cjf646/ESEProj/README.md

# ESEProj
Final Capstone project for Electronic Systems Engineering at the University of Regina.
