cjf646/ESEProj/Box Stuff/Box Stuff/Pics/Back wall.jpg

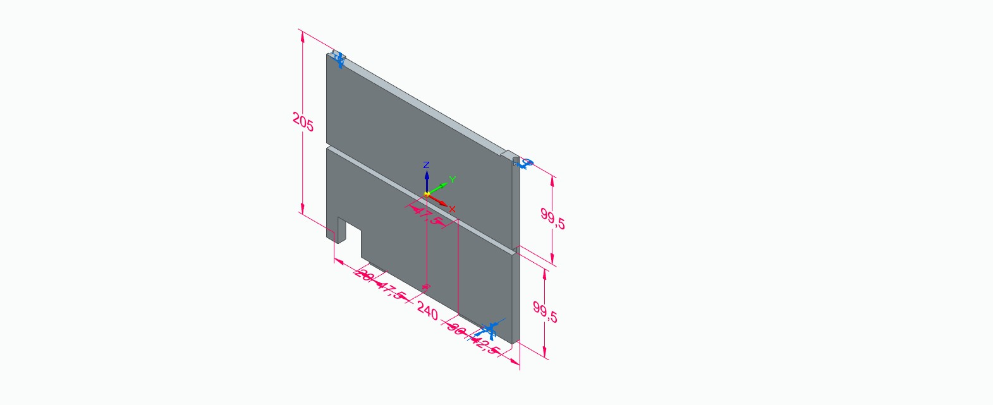
Box Stuff/Box Stuff/Pics/Back wall.jpg
