cjf646/ESEProj/Box Stuff/Box Stuff/Pics/Box (FrontxTopxRight).jpg

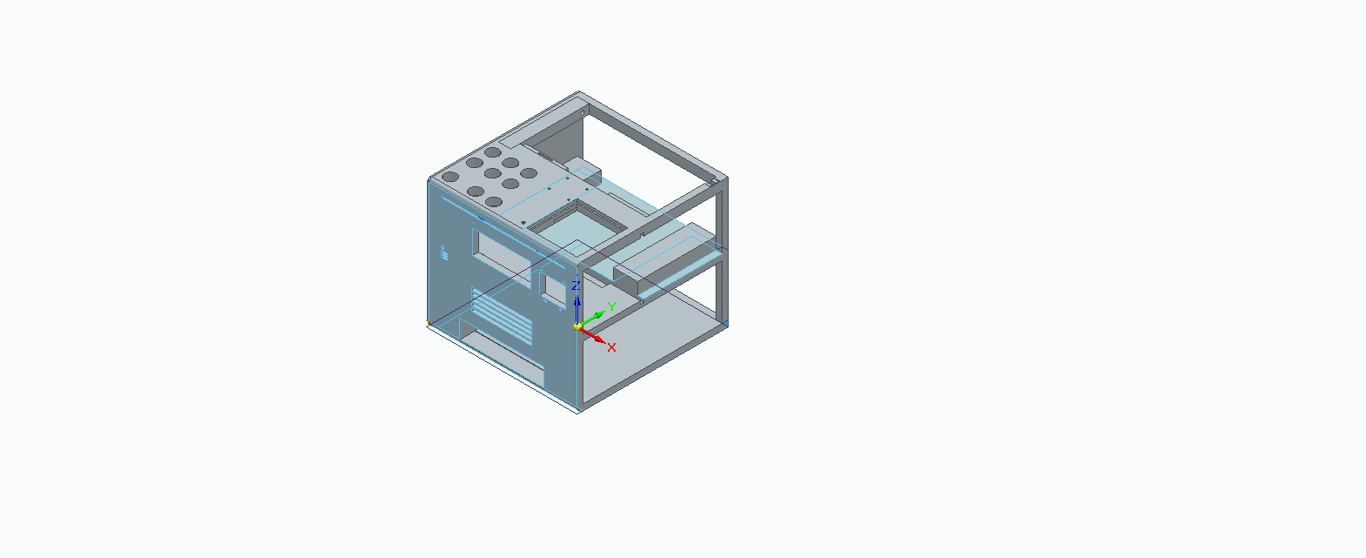
Box Stuff/Box Stuff/Pics/Box (FrontxTopxRight).jpg
