cjf646/ESEProj/Box Stuff/Box Stuff/Pics/Box (RightxTopxBack).jpg

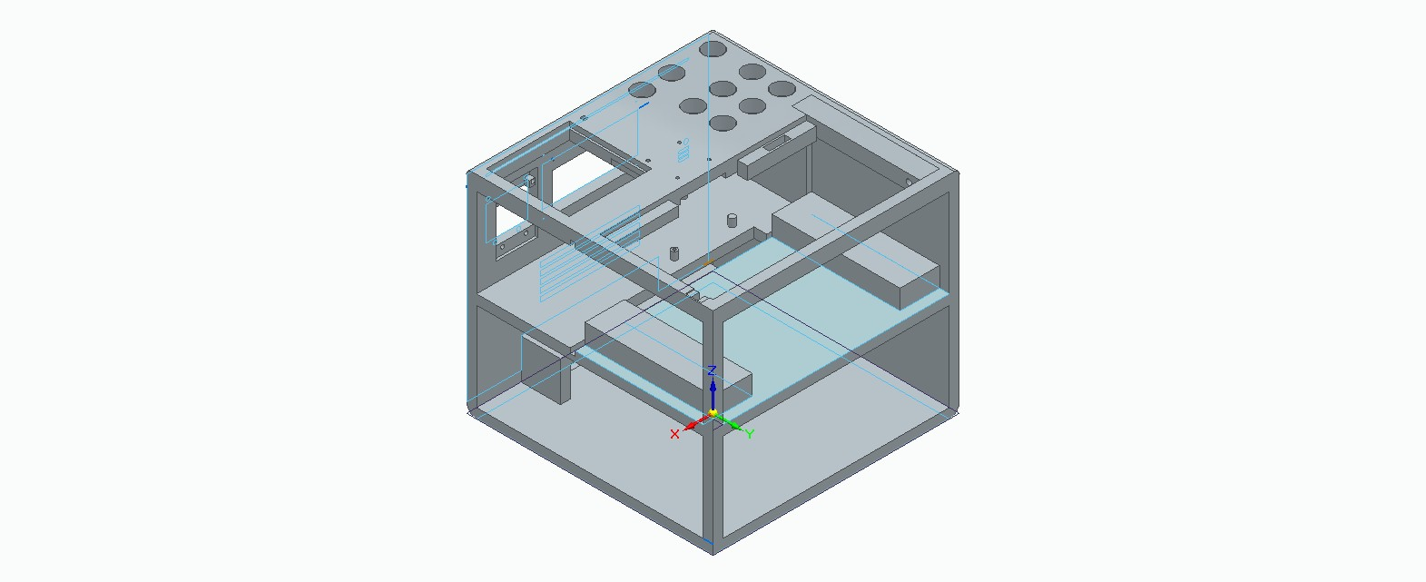
Box Stuff/Box Stuff/Pics/Box (RightxTopxBack).jpg
