cjf646/ESEProj/Box Stuff/Box Stuff/Pics/floor wall.jpg

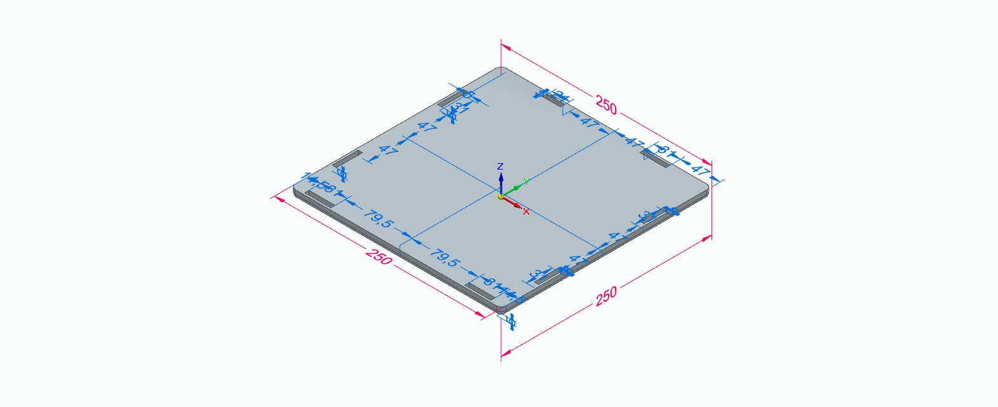
Box Stuff/Box Stuff/Pics/floor wall.jpg
