cjf646/ESEProj/Box Stuff/Box Stuff/Pics/front wall.jpg

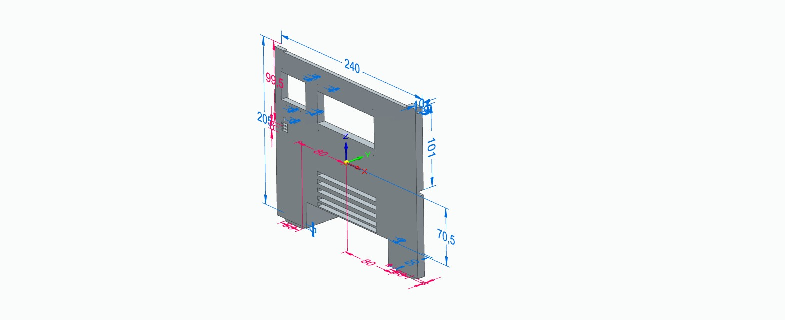
Box Stuff/Box Stuff/Pics/front wall.jpg
