cjf646/ESEProj/Box Stuff/Box Stuff/Pics/left wall.jpg

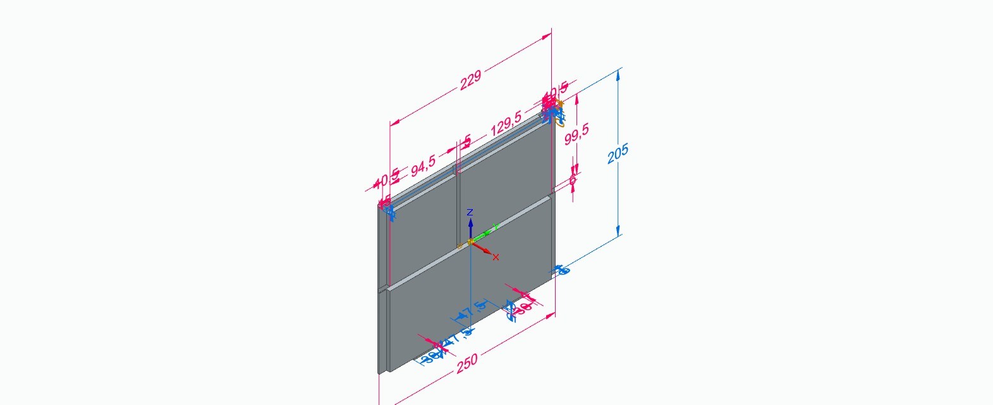
Box Stuff/Box Stuff/Pics/left wall.jpg
