cjf646/ESEProj/Box Stuff/Box Stuff/Pics/Lid.jpg

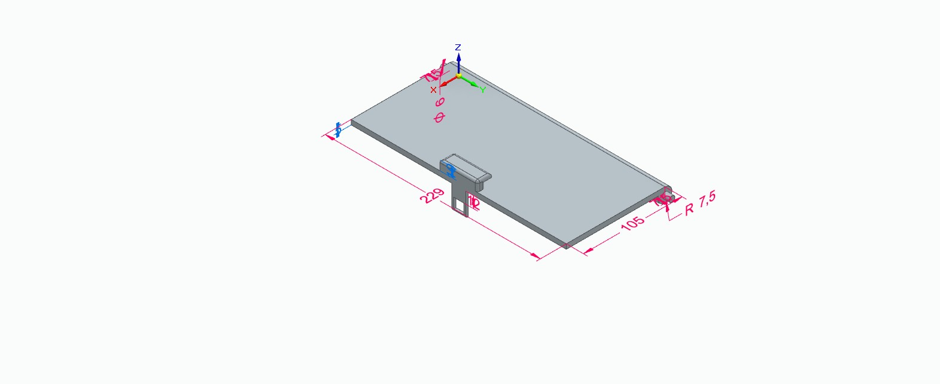
Box Stuff/Box Stuff/Pics/Lid.jpg
