cjf646/ESEProj/Box Stuff/Box Stuff/Pics/middle wall.jpg

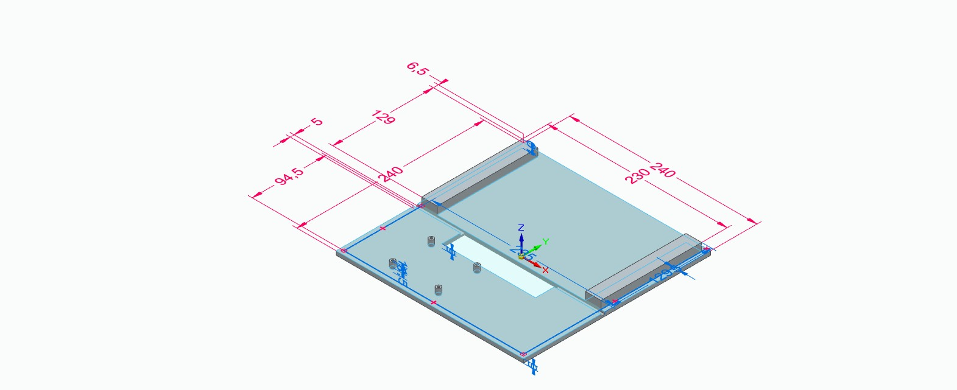
Box Stuff/Box Stuff/Pics/middle wall.jpg
