cjf646/ESEProj/Box Stuff/Box Stuff/Pics/right wall.jpg

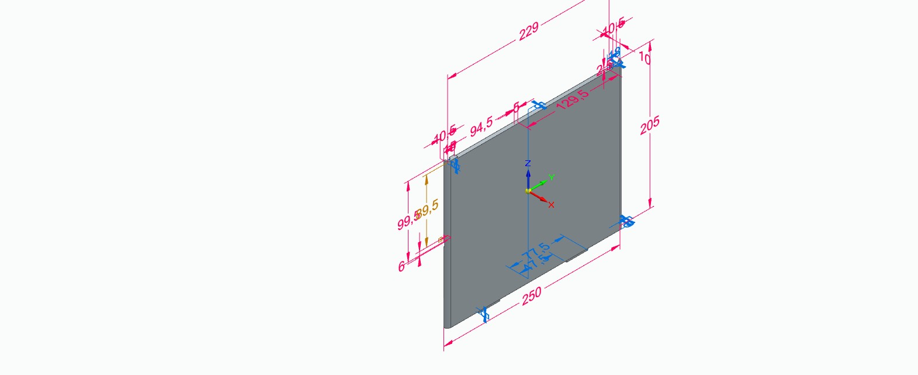
Box Stuff/Box Stuff/Pics/right wall.jpg
