cjf646/ESEProj/Box Stuff/Box Stuff/Pics/Sliding wall.jpg

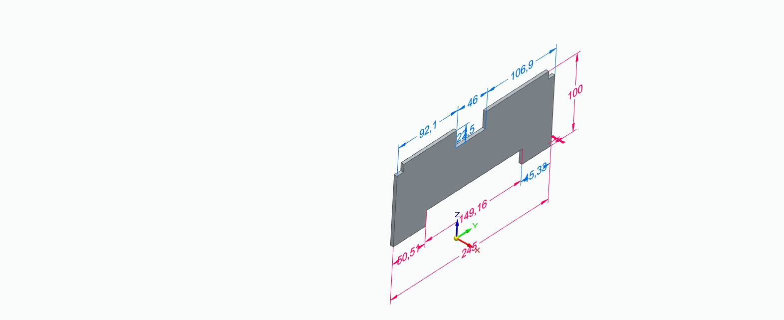
Box Stuff/Box Stuff/Pics/Sliding wall.jpg
