cjf646/ESEProj/Box Stuff/Box Stuff/Pics/top wall.jpg

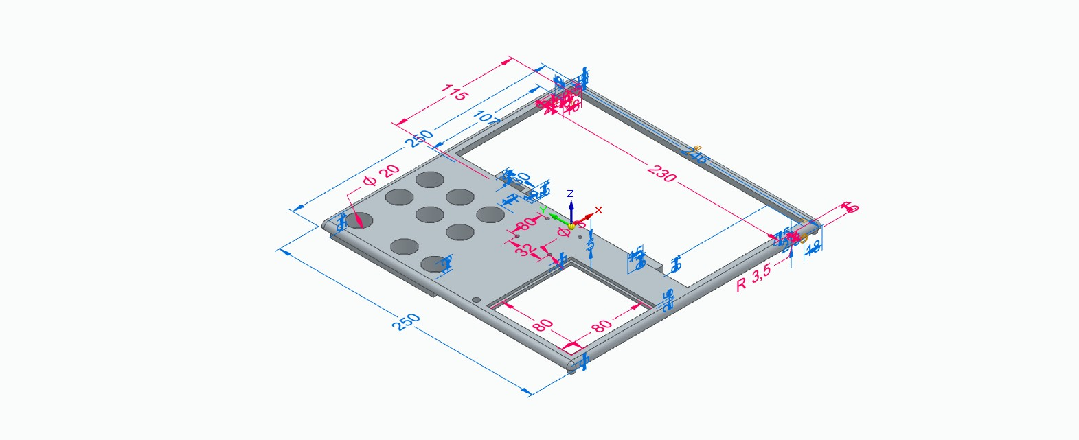
Box Stuff/Box Stuff/Pics/top wall.jpg
