cjf646/ESEProj/Box Stuff/Box Stuff/stl/Lid.stl

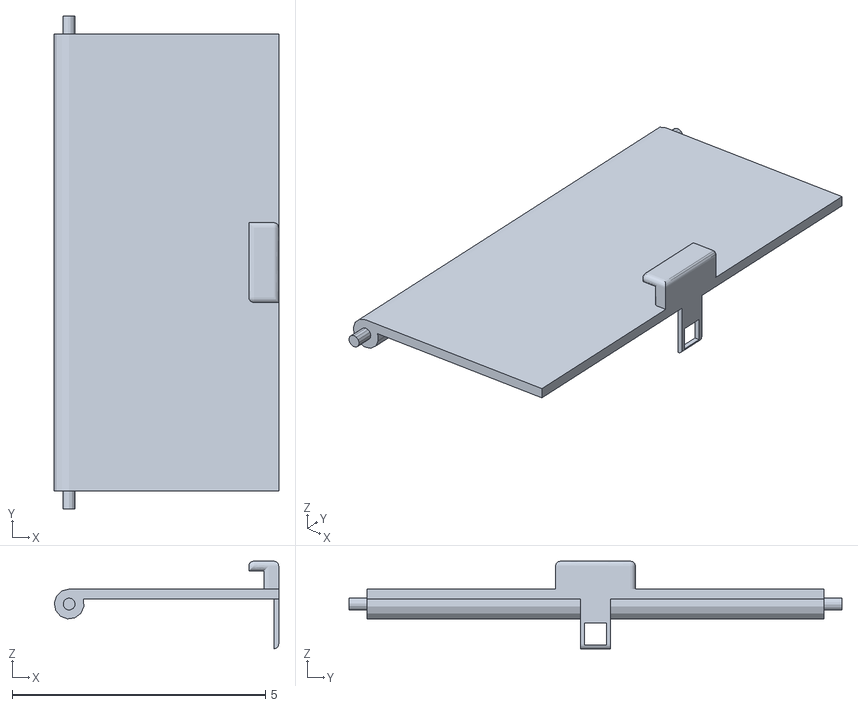
[picture p18: CAD file, 2023-02-28]
Box Stuff/Box Stuff/stl/Lid.stl
4.43 x 9.72 x 1.73
