cjf646/ESEProj/Box Stuff/Box Stuff/numb.stl

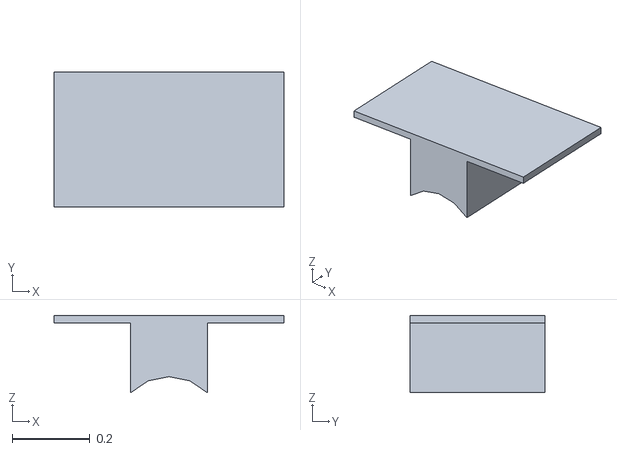
[picture p19: CAD file, 2023-01-17]
Box Stuff/Box Stuff/numb.stl
0.591 x 0.346 x 0.199
