cjf646/ESEProj/Box Stuff/Box Stuff/stl/front wall.stl

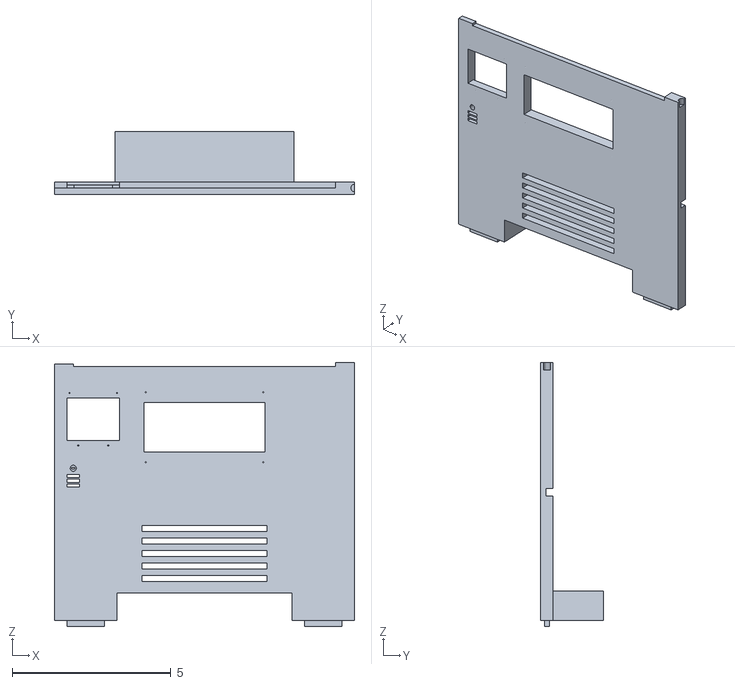
[picture p20: CAD file, 2023-01-30]
Box Stuff/Box Stuff/stl/front wall.stl
9.45 x 1.97 x 8.33
