cjf646/ESEProj/Box Stuff/Box Stuff/Sliding wall.stl

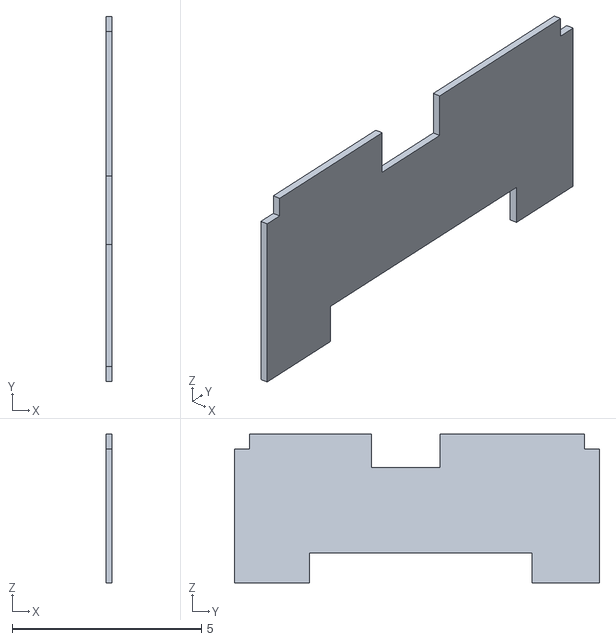
[picture p21: CAD file, 2023-01-17]
Box Stuff/Box Stuff/Sliding wall.stl
0.157 x 9.65 x 3.94
