cjf646/ESEProj/Box Stuff/Box Stuff/stl/floor wall.stl

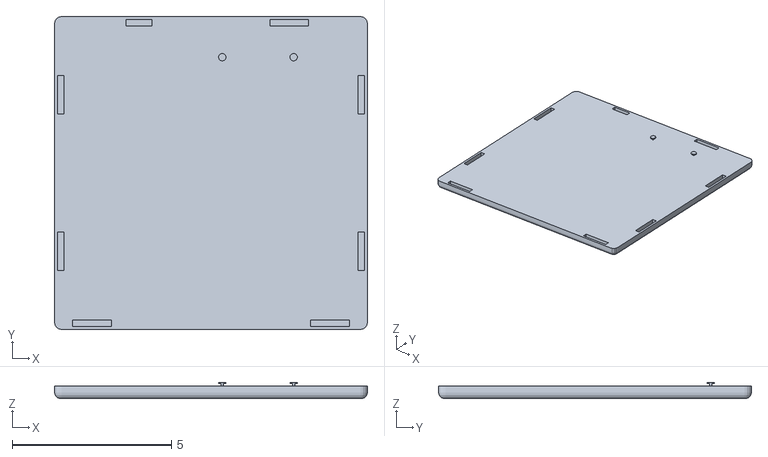
[picture p22: CAD file, 2023-01-30]
Box Stuff/Box Stuff/stl/floor wall.stl
9.84 x 9.84 x 0.512
