cjf646/ESEProj/Box Stuff/Box Stuff/Box.stl

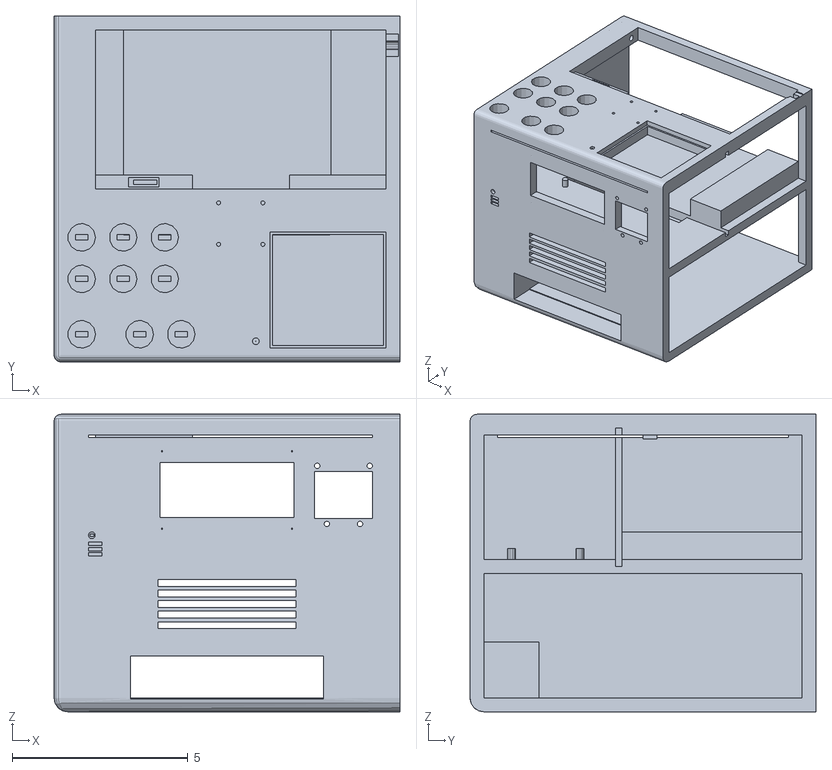
[picture p23: CAD file, 2023-01-17]
Box Stuff/Box Stuff/Box.stl
9.84 x 9.84 x 8.46
