cjf646/ESEProj/Box Stuff/Box Stuff/stl/Back wall.stl

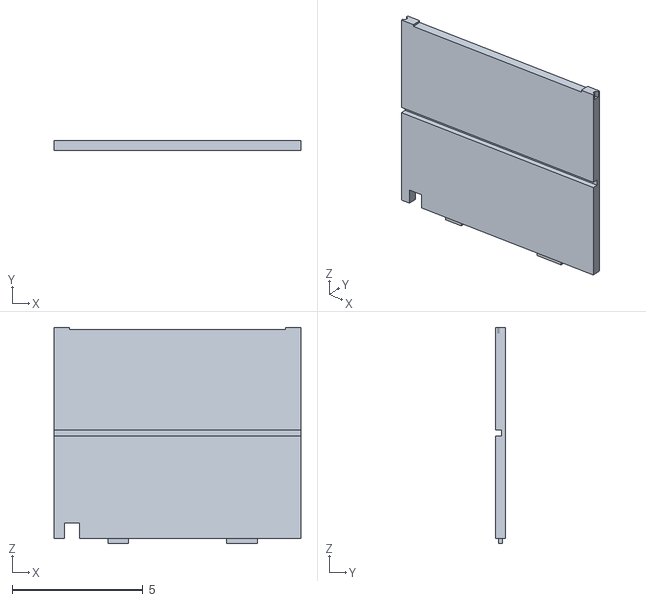
[picture p24: CAD file, 2023-01-30]
Box Stuff/Box Stuff/stl/Back wall.stl
9.45 x 0.394 x 8.27
