cjf646/ESEProj/Box Stuff/Box Stuff/stl/top wall.stl

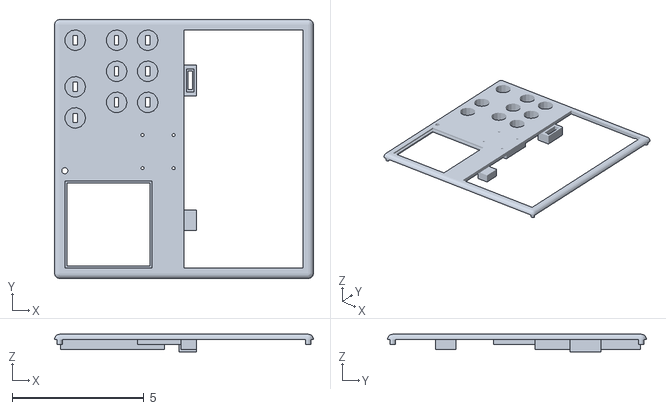
[picture p25: CAD file, 2023-01-28]
Box Stuff/Box Stuff/stl/top wall.stl
9.84 x 9.84 x 0.669
