cjf646/ESEProj/Box Stuff/Box Stuff/stl/left wall.stl

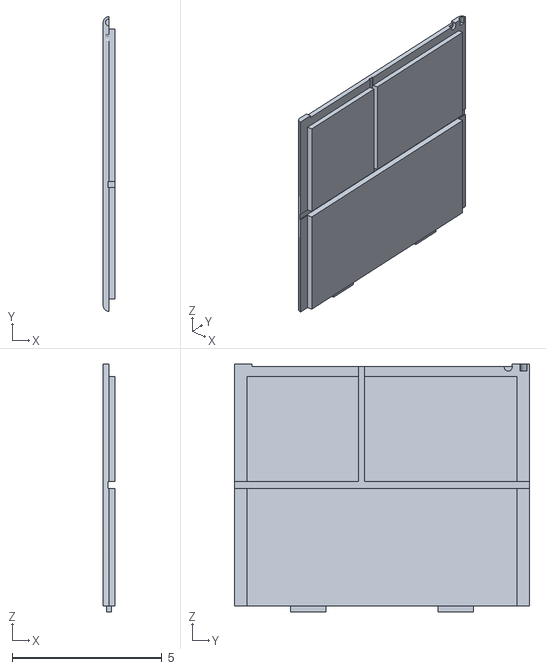
[picture p26: CAD file, 2023-01-28]
Box Stuff/Box Stuff/stl/left wall.stl
0.394 x 9.84 x 8.27
