cjf646/ESEProj/Box Stuff/Box Stuff/stl/middle wall.stl

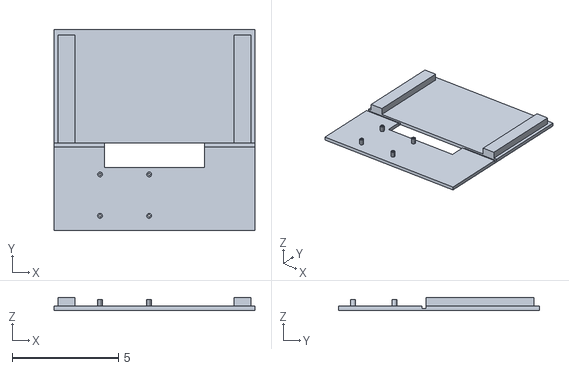
[picture p27: CAD file, 2023-01-27]
Box Stuff/Box Stuff/stl/middle wall.stl
9.45 x 9.45 x 0.591
