cjf646/ESEProj/(list of files, cad)

Other CAD files:
Box Stuff/Box Stuff/box_updated_jan11.dwg
Schematics/rasbpi.dwg
Schematics/power.dwg
Box Stuff/Box Stuff/stl/right wall.stl
Box Stuff/Box Stuff/Lid.stl
Box Stuff/Box Stuff/top wall.stl
