cjf646/ESEProj/Schematics/rasbpi8_5x11.pdf

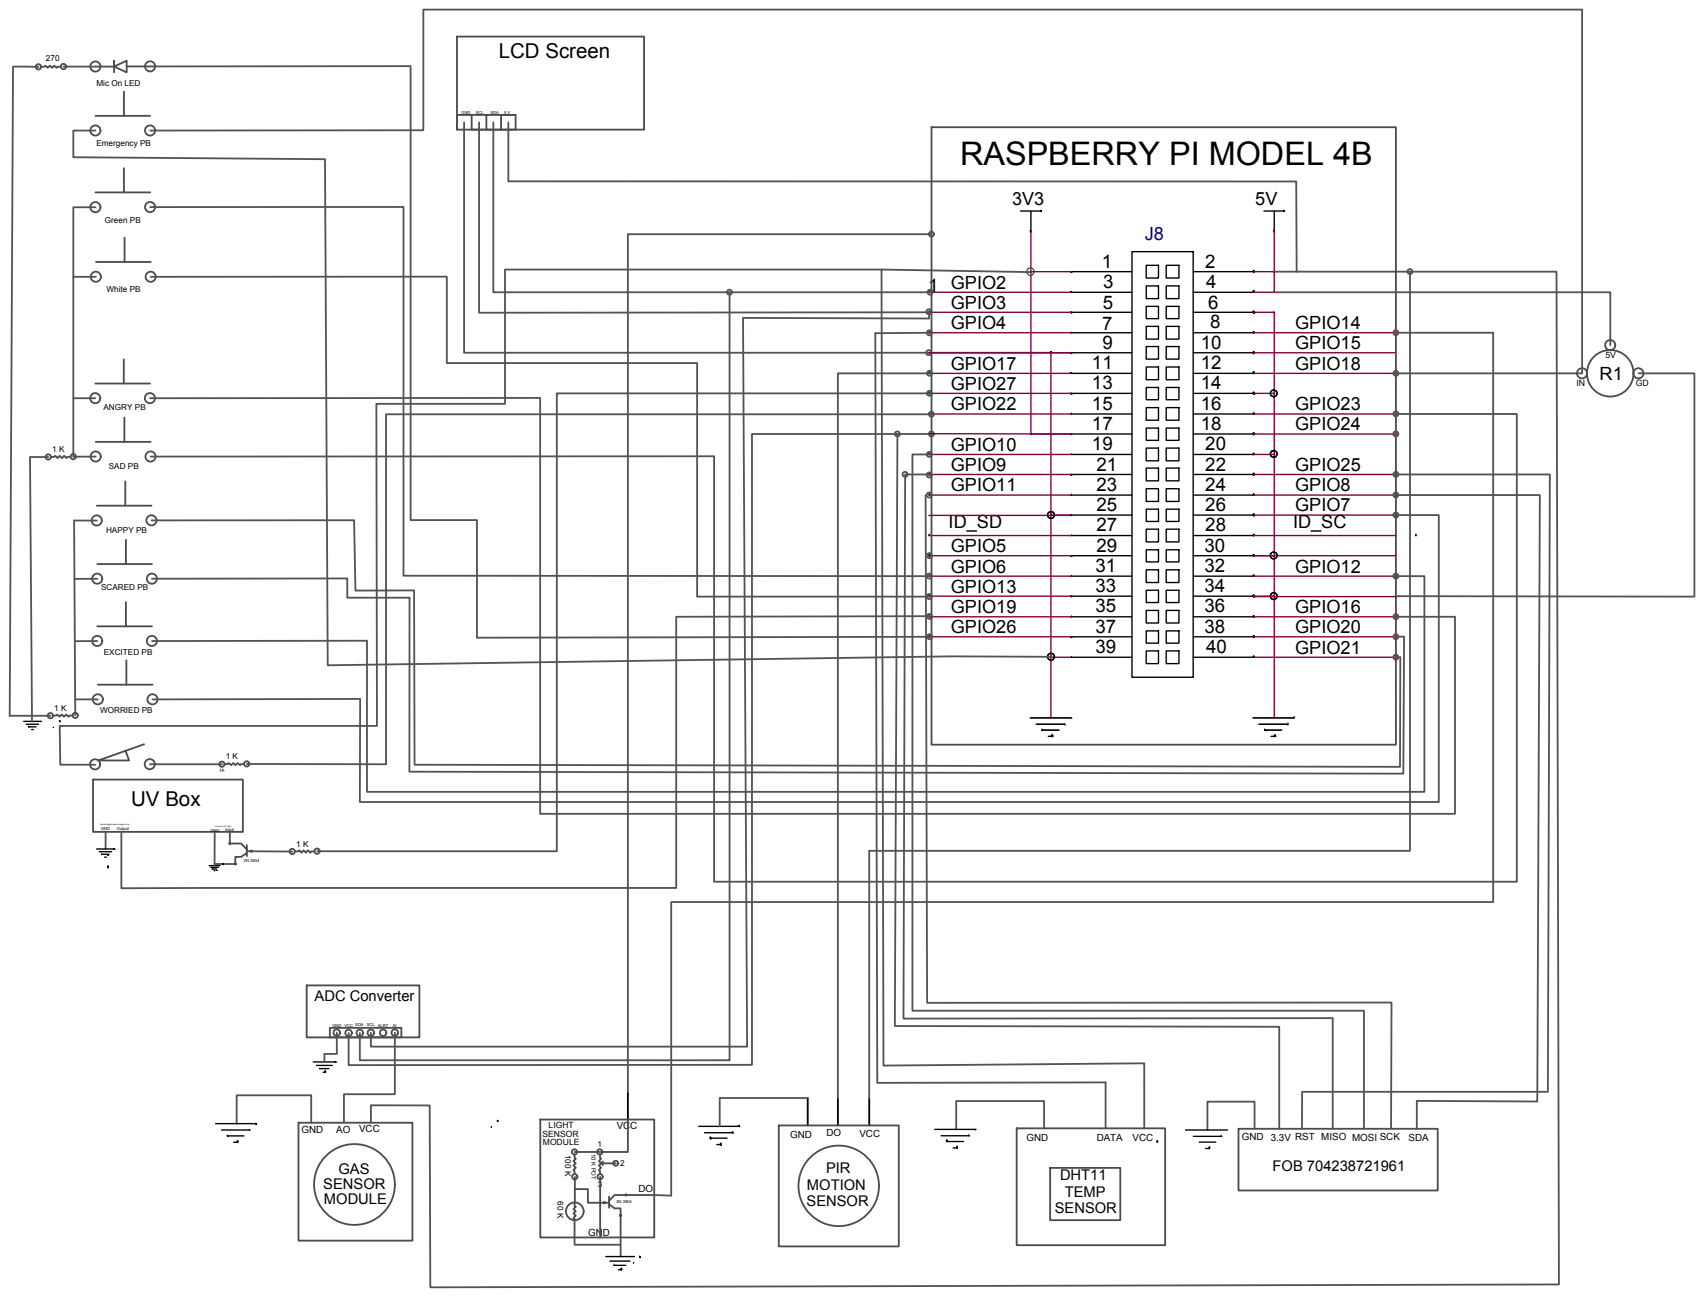
[picture p28: page 1]
5V J8 GPIO2 GPIO3 GPIO4 GPIO17 GPIO27 GPIO22 GPIO10 GPIO9 GPIO11 ID_SD GPIO5 GPIO6 GPIO13 GPIO19 GPIO26; GPIO14 GPIO15 GPIO18 GPIO23 GPIO24 GPIO25 GPIO8 GPIO7 ID_SC GPIO12 GPIO16 GPIO20 GPIO21 RASPBERRY PI MODEL 4B GNDMOTION SENSOR; GND; DATA DHT11 SENSOR PIR; VCC TEMP GND MODULE SENSOR LIGHT LCD Screen; 68 1 Green PB White PBUV Box GND; Output; Input; FOB 704238721961 GND 3.3V RST MISO MOSI SCK SDA GNDMODULE SENSOR GAS; DO AO VCC; VCC GND VCC SDA SCL ALRT AI; VCC GND; SCL; SDA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

10 K POT 60 K 5V IN GD 1A 1 K
