cjf646/ESEProj/Schematics/TEMPLATE PI.pdf

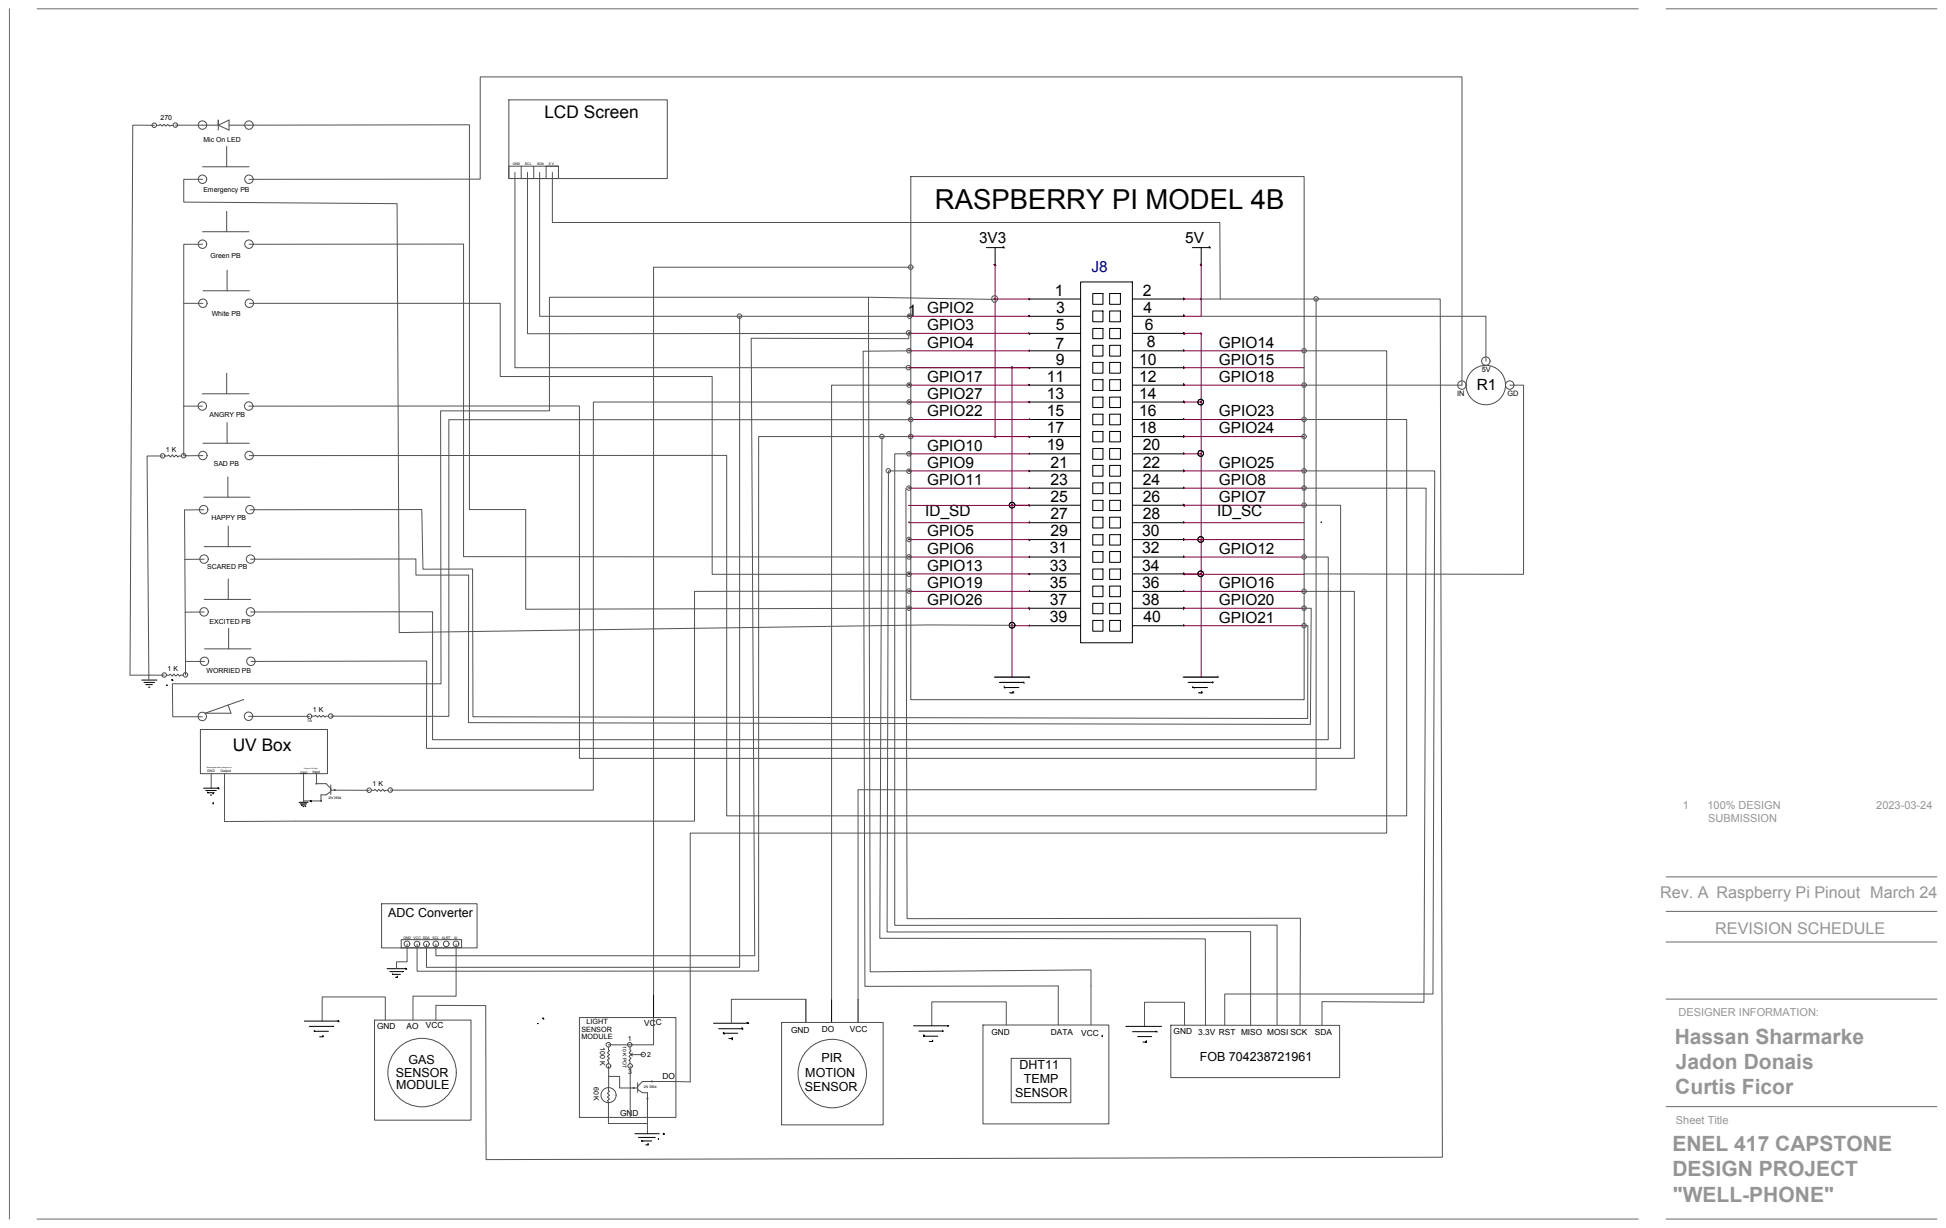
[picture p29: page 1]
Sheet Title DESIGNER INFORMATION: Hassan Sharmarke Jadon Donais Curtis Ficor REVISION SCHEDULE Rev. A Raspberry Pi Pinout March 24 ENEL 417 CAPSTONE DESIGN PROJECT "WELL-PHONE" 1; 100% DESIGN SUBMISSION; 5V J8 GPIO2 GPIO3 GPIO4 GPIO17 GPIO27 GPIO22 GPIO10 GPIO9 GPIO11 ID_SD GPIO5 GPIO6 GPIO13 GPIO19 GPIO26; GPIO14 GPIO15 GPIO18 GPIO23 GPIO24 GPIO25 GPIO8 GPIO7 ID_SC GPIO12 GPIO16 GPIO20 GPIO21 RASPBERRY PI MODEL 4B GNDMOTION SENSOR; GND; DATA DHT11 SENSOR PIR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
