cjf646/ESEProj/Schematics/power8_5x11.pdf

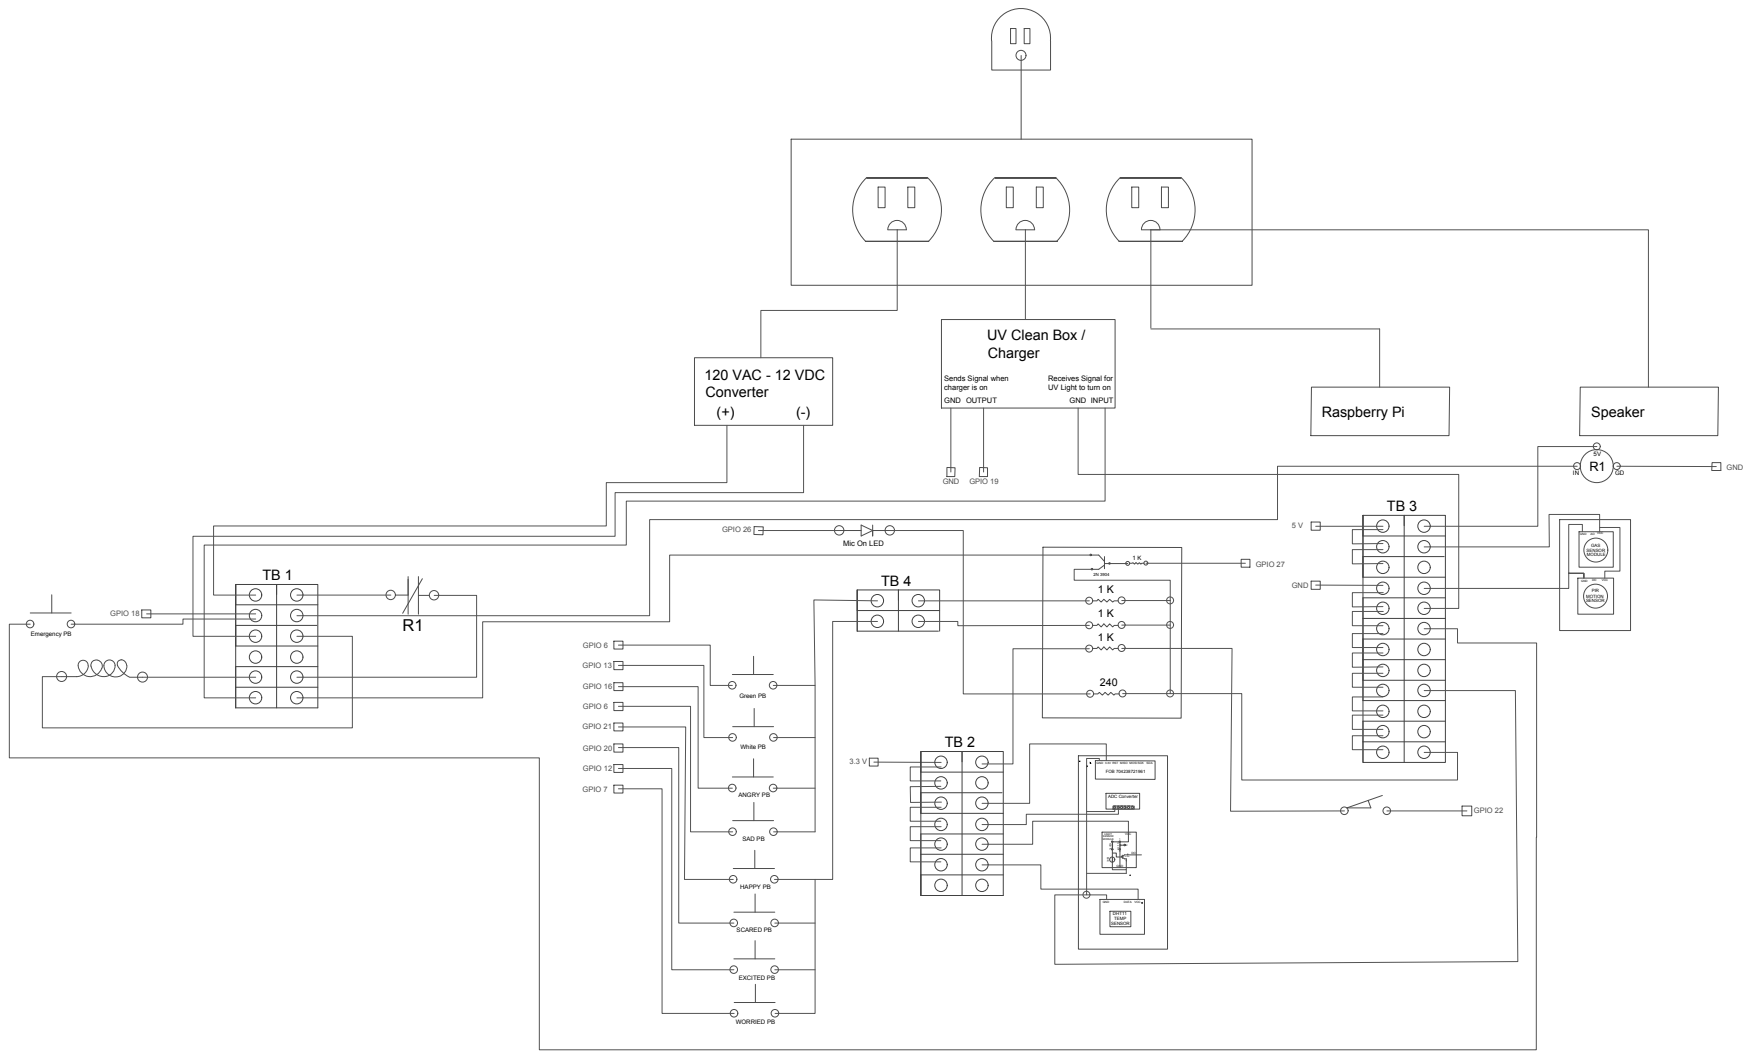
[picture p30: page 1]
120 VAC - 12 VDC Converter (+); Raspberry Pi UV Clean Box / Charger GND OUTPUT; GND INPUT Sends Signal when charger is on; Receives Signal for UV Light to turn on; 1 K 1 K 1 K 1 K240 Green PB White PB ANGRY PB SAD PB HAPPY PB SCARED PB EXCITED PB WORRIED PB Emergency PB; 3.3 V Mic On LED; TB 3 5 V GND; GD GPIO 18; GPIO 19 GPIO 6 GPIO 13 GPIO 16; GPIO 22 GPIO 6 GPIO 21 GPIO 20 GPIO 12 GPIO 7; GPIO 26; GND GNDMOTION SENSOR GND; DATA DHT11 SENSOR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
