cjf646/ESEProj/Schematics/power.pdf

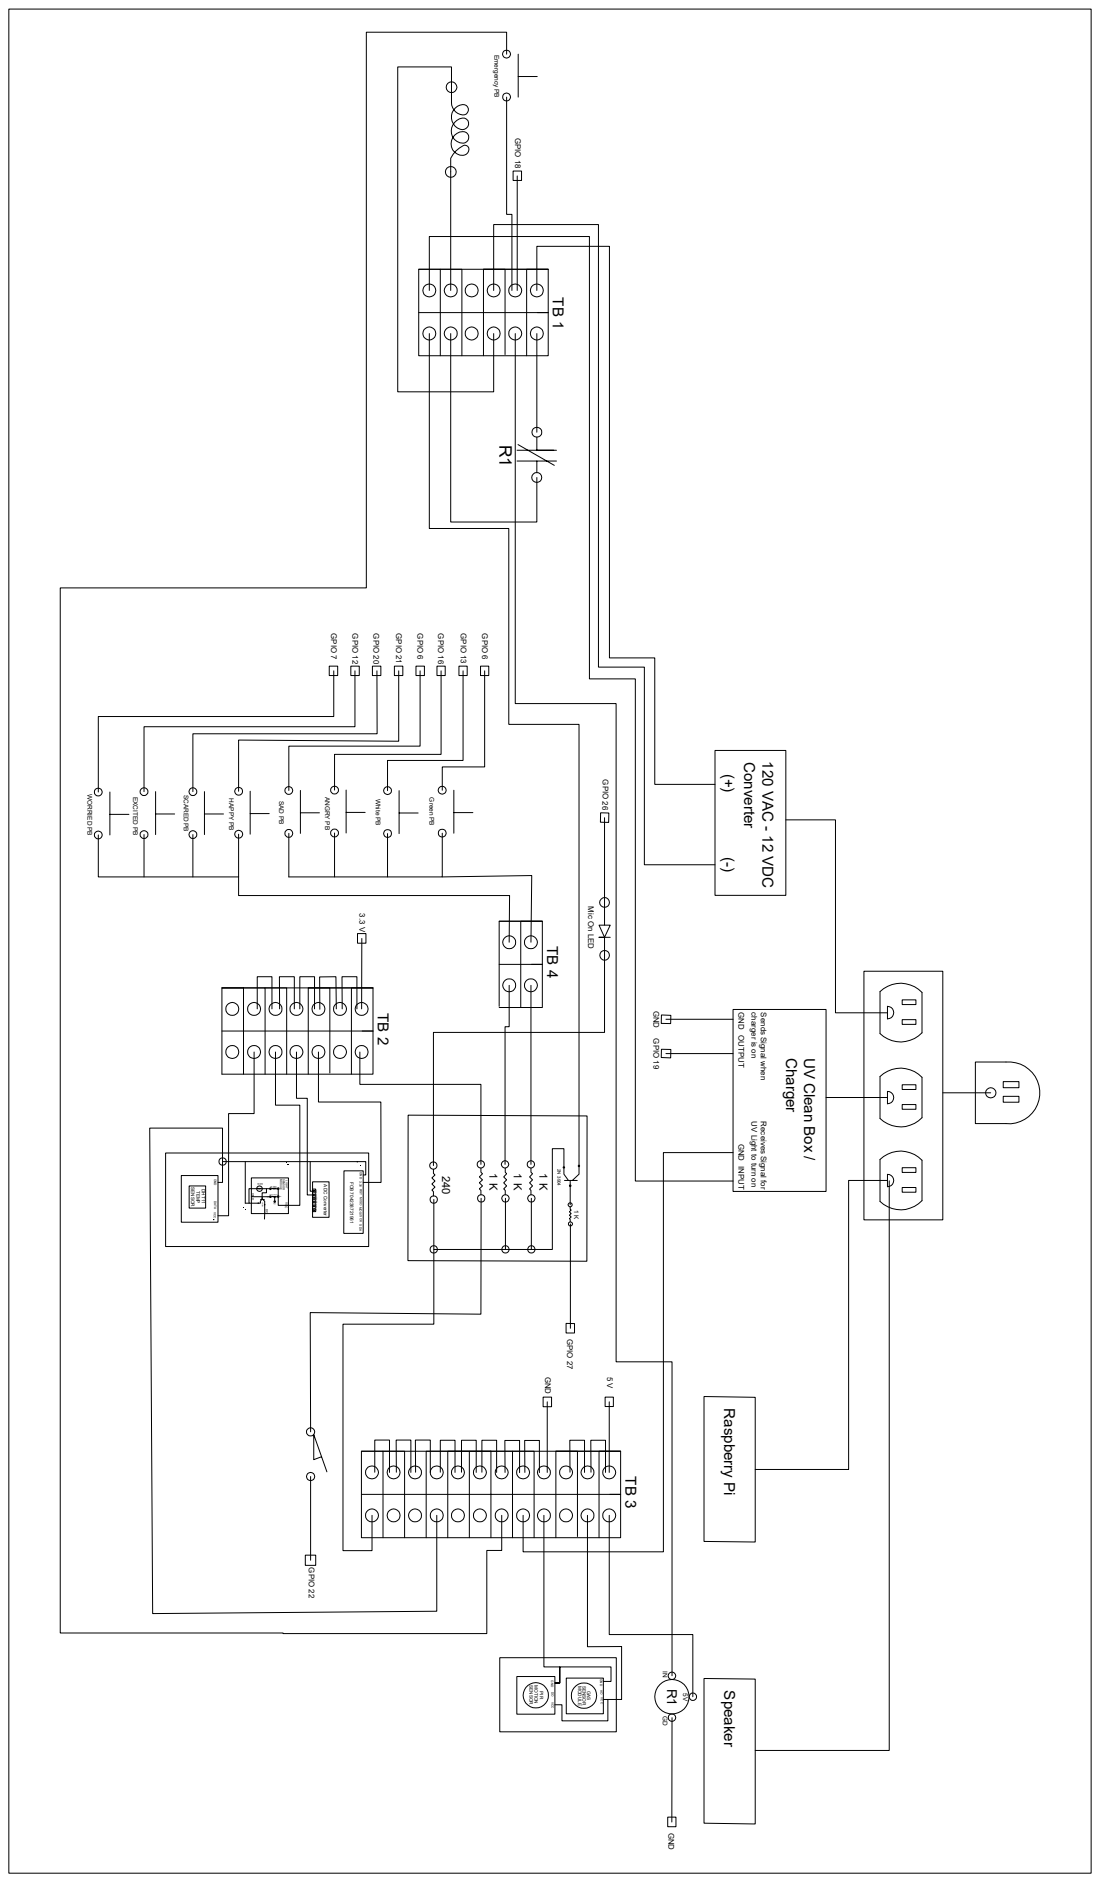
[picture p31: page 1]

R1 Converter 120 VAC - 12 VDC (+) (-) Raspberry Pi Charger UV Clean Box / GND OUTPUT GND INPUT charger is on Sends Signal when UV Light to turn on Receives Signal for 1 K 240 1 K1 K1 K ANGRY PB White PB Green PB HAPPY PB SAD PB SCARED PB WORRIED PB EXCITED PB Emergency PB 2N 3904 TB 4 TB 1 3.3 V Mic On LED TB 2 TB 3 GND 5 V R15V IN GD GPIO 18 GPIO 19 GPIO 16 GPIO 13 GPIO 6 GPIO 22 GPIO 7 GPIO 12 GPIO 20 GPIO 21 GPIO 6 GPIO 26 GND GNDSENSOR MOTION GND DATA DHT11 SENSOR PIR VCC TEMP GND MODULE SENSOR LIGHT FOB 704238721961 3.3V GND RST MISO MOSI SCK SDA

VCC AO VCC GND VCC SDA SCL ALRT AI DO VCC ADC Converter 100 K

GNDMODULE SENSOR GAS DO
