cjf646/ESEProj/Schematics/rasbpi.pdf

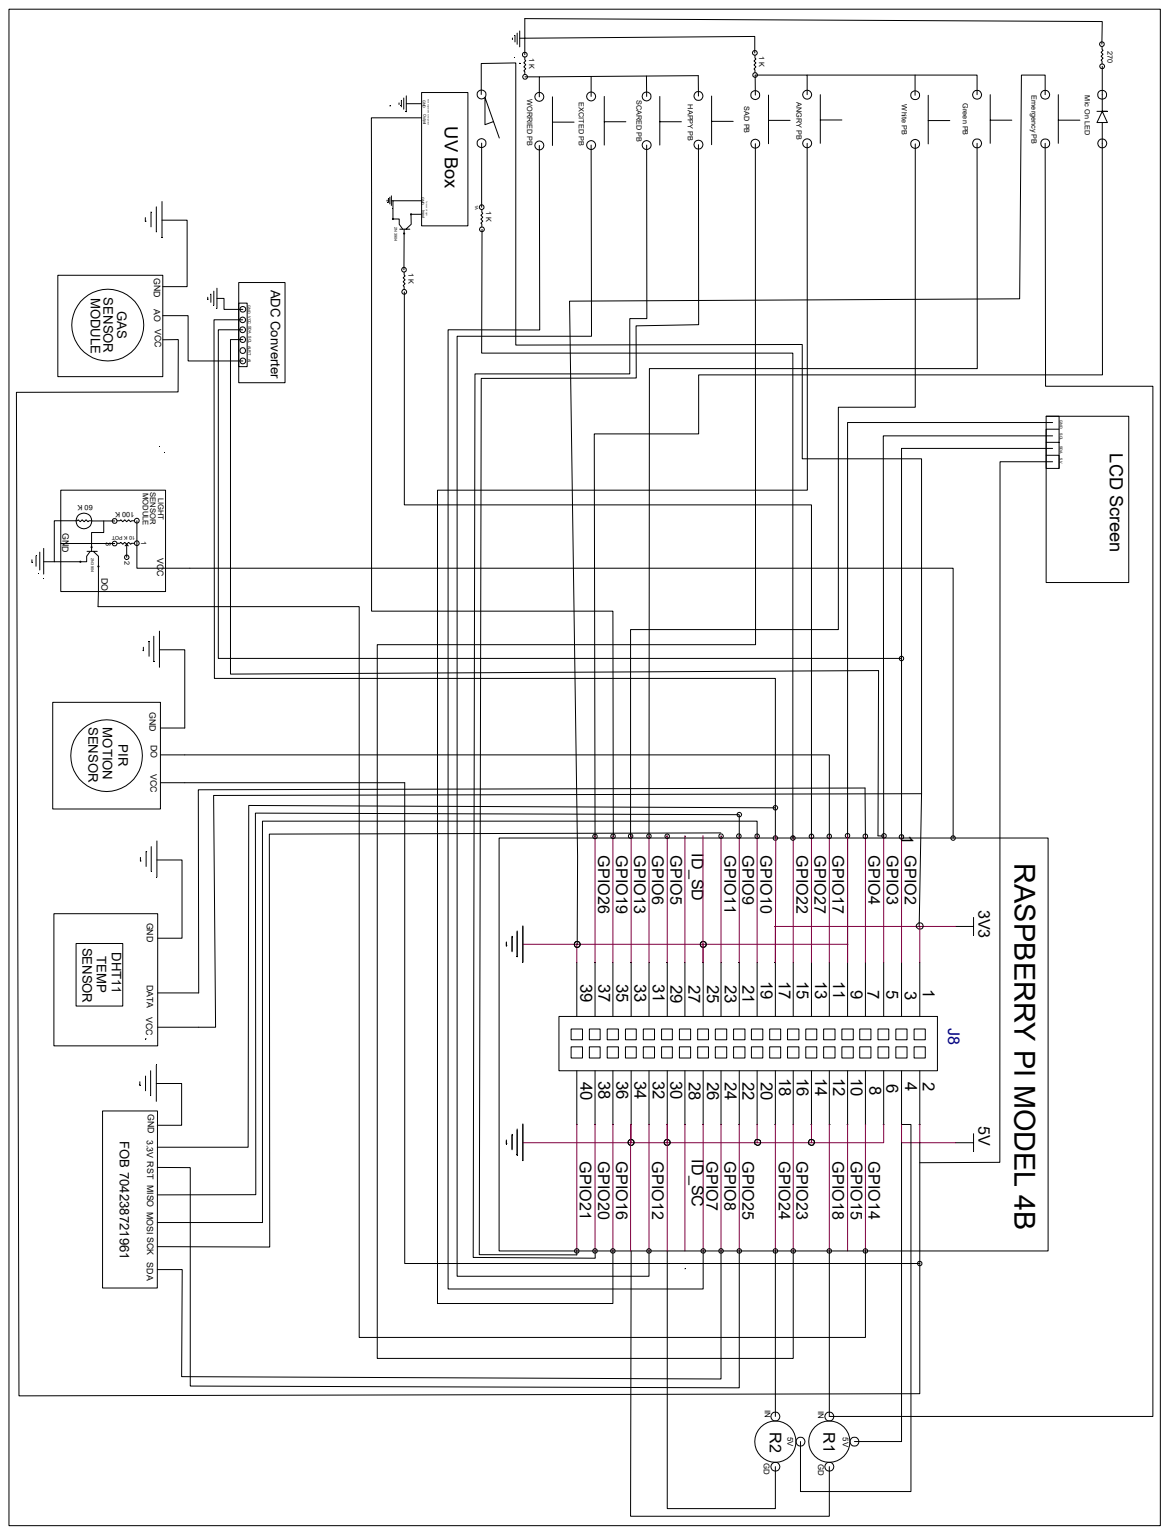
[picture p32: page 1]
10 K POT

3V3 5V J8 GPIO26 GPIO19 GPIO13 GPIO6 GPIO5 ID_SD GPIO11 GPIO9 GPIO10 GPIO22 GPIO27 GPIO17 GPIO4 GPIO3 GPIO2 139373533312927252321 1917151311 4038363432302826242220 181614121042 GPIO21 GPIO20 GPIO16 GPIO12 ID_SC GPIO7 GPIO8 GPIO25 GPIO24 GPIO23 GPIO18 GPIO15 GPIO14 RASPBERRY PI MODEL 4B GNDSENSOR MOTION GND DATA DHT11 SENSOR PIR VCC TEMP GND MODULE SENSOR LIGHT LCD Screen 9753 86 1 White PB Green PBUV Box GND Output Input GND FOB 704238721961 3.3V GND RST MISO MOSI SCK SDA GNDMODULE SENSOR GAS DO VCC AO VCC GND VCC SDA SCL ALRT AI DO VCC 5 V SDA SCL GND 1 K 2N 3904 ANGRY PB HAPPY PB SAD PB WORRIED PB EXCITED PB SCARED PB Turns on UV Light Sends signal when charger is on R2 R1 ADC Converter 1 K Emergency PB 270 Mic On LED 1 K

60 K 5V5V ININ GD GD 1A 1 K
