cjf646/ESEProj/(commit log)

2023-01-16 Add files via upload
    Added limit switch part and handle to box lid
2023-01-17 Add files via upload
    expanded platform, moved pb circles, added space for LED strips, rerounded corners
2023-01-17 Add files via upload
    Added:
    -hole to easily install door
    -pin for glass door cover to swivel
    -moved pi feet to be closer to corner
    -mic on LED hole
    -Box LED lights
    Still to do:
    -add parent fob spot
    -move navigation PB's closer to glass cut out
2023-01-17 Add files via upload
    STL file commit
    [Box.stl, Lid.stl, Sliding wall.stl, numb.stl]
2023-01-18 Rename Document/Schematics/dfgfhgjh to Documents/Schematics/ dfgfhgjh
2023-01-18 updated database
    contains alarm time, activities, temp-sensor
2023-01-18 Adds sleep sensor data
2023-01-20 Add files via upload
    Added top wall separate part to see if prices vary in printing
    [box_updated_jan11.dwg, top wall.stl]
2023-01-24 Add files via upload
    Changed top wall drawing to correct file, uploaded wrong one
    [top wall.stl]
2023-01-25 Alarm clock working
    alarm clock triggering when current_time == alarm_time
2023-01-27 Add files via upload
    Added back, right and left wall. fitted all walls together and made nubs for bottom wall to fit together properly.
    [Back wall.stl, Lid.stl, Sliding wall.stl, floor wall.stl, front wall.stl, left wall.stl, middle wall.stl, right wall.stl]
2023-01-28 Add files via upload
    1. Fine tuned box walls and floors, ensured they would fit together
    2. added spinner hole for camera window
    3. Measured box lid and ensured fit with lock
    4. Added hole for limit switch
    5. created .jpeg images to make commissioning guide with
    [Back wall.stl, Box.stl, Lid.stl, Sliding wall.stl, box_updated_jan11.dwg, floor wall.stl, front wall.stl, left wall.stl]
2023-01-28 Delete Box.stl
    commited other part together with folder
    [Box.stl]
2023-01-28 Delete Lid.stl
    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
    [Lid.stl]
2023-01-28 Delete top wall.stl
    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
    [top wall.stl]
2023-01-28 Delete numb.stl
    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
    [numb.stl]
2023-01-28 Delete box_updated_jan11.dwg
    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
    [box_updated_jan11.dwg]
2023-01-28 Delete Sliding wall.stl
    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
    [Sliding wall.stl]
2023-01-28 Delete Box Stuff/stl directory
    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
    [Back wall.stl, Lid.stl, Sliding wall.stl, floor wall.stl, front wall.stl, left wall.stl, middle wall.stl, right wall.stl]
2023-01-30 Add files via upload
    Final commit before printing. Added numbs for power bar and shrunk sensor window
    [Back wall.stl, floor wall.stl, front wall.stl]
2023-02-16 sleep monitoring, camera, activity completion
2023-02-16 sleep monitoring, camera. activity completion
2023-02-17 Initial commit for plotting temperature data
2023-02-17 Initail commit for plotting motion sensor data
2023-02-17 Initial commit for reading data from wireless fob
2023-02-17 Initial commit of PI Schematic dwg drawing
    [rasbpi.dwg]
2023-02-21 Add files via upload
    Connected PBs,
    Labeled PBs and terminals
    [rasbpi.dwg]
2023-02-21 Add files via upload
    Added start of power schematic
    Labeled more Rasp Pi GPIO pins
    [power.dwg, rasbpi.dwg]
2023-02-24 includes all stages
2023-02-24 Check limit switch state
    notifying parent if box was opened during night so they can either activate box to open with fob or press emergency button which will lose their points accumulated from session and also lose their streak
2023-02-28 Add files via upload
    Changed lid dimensions
    [Lid.stl]
2023-03-02 Updated to better display time values on x-axis
2023-03-02 Add files via upload
    rasbp:
    1. Added mic on LED
    2. Added E PB
    3. Added 5 volt input on relays
    Power:
    1. Added TB1 connections to lock and lights
    2. Added UV clean box
    [power.dwg, rasbpi.dwg]
2023-03-02 Updated for Curti's Raspberry Pi
2023-03-10 Add files via upload
    Final Drawings before build.. Finalized all GPIO pins and cross referenced them with code
    [power.dwg, rasbpi.dwg]
2023-03-10 Add files via upload
    Updated things
    [rasbpi.dwg]
2023-03-11 Add files via upload
    Added Terminal blocks and corrected connection for EPB to relay
    [power.dwg, rasbpi.dwg]
2023-03-13 Add files via upload
    Added connections for the envir sensors to power.dwg
    [power.dwg, rasbpi.dwg]
2023-03-23 Add files via upload
    final commit
    [power.dwg, rasbpi.dwg]
2023-03-23 Add files via upload
    PDF Schematics
2023-03-25 Add files via upload
    Edited R2 out of PI Pinout
    [power.dwg, rasbpi.dwg]
